WangXuan95/UniPlug-FPGA/EP4CE22/用户手册.pdf

# UniPlug-FPGAÿ%Ü£EP4CE22á§

^rÃ˛

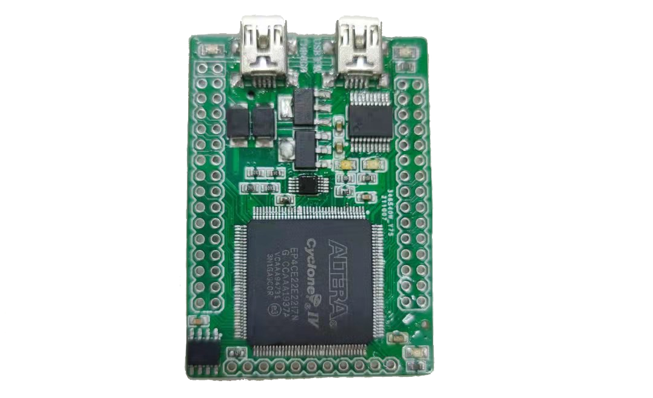
[picture p5: figure]

# https://github.com/WangXuan95

2021c9

8¹

1 {0 | 2
2 *–IO`² | 3
3 ⁄©L | 4
4 É'^áÜ°ƒ | 6
5 .qsf£Quartusë8ò©á§⁄Â | 7
6 ßSzòð | 8

1 {0

# UniPlug-FPGA¥ò±N»-

# !$§!¥^!*–5rFPGA ÿ%Ü"å±^ä.Oß½O.ÜßV \DRAM!±!USB!ADC/DAC!—™!VGA!îfi ß±§½õzıU"ßX⁄µ„Ñ„1" ßPk±eA:µ

# - FPGA .“èAltera Cyclone IV EP4CE22E22ßPk22kLE ‹6]

# ⁄594kbit Sò;"

# - 8§USB-Blaster£FPGAe1N£Ï§ßÿIá OUSB-Blaster “U¶^"

- 8§ ù)µ

# – USB-UART£CH340E§ß^u⁄˛†Åœ&"

# – 8MB SPI-flash£W25Q64§^rð"

# – Micro SD k¯"

# – CAN PHY °£TJA1050§ß^uCANoÇœ&"

# – 3 á^rLED "

# - n|*–IOµIOAßIOBß⁄IOCß43 á œIO"

# 5øµcIárIOB ⁄IOC >

# —\^aÇlÎ?ø>

# ˛ßƒKFPGA ÚÃ{§ı˛DßS" çÑe©/*–IO`²⁰

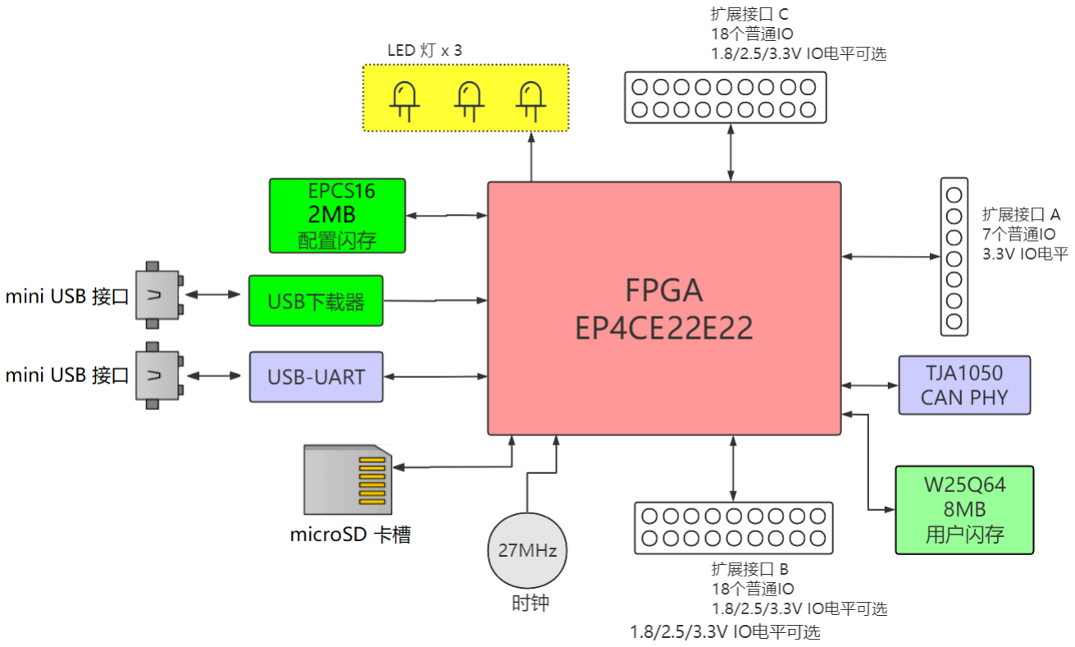
[picture p6: figure]

# „ 1: UniPlug-FPGAÿ%ÜX⁄µ„

# 2 *–IO`²

# *–IO X„2 ßù)3 áV¸2.54mmmÂ¸-

# µIOAßIOB⁄IOC"Ÿ•µ

# - IOA è½3.3V 7 á œIO"

# - IOB åòè18 á œIO ß>²å^aÇòè1.8V!2.5V ½3.3V "

# - IOC åòè18 á œIO ß>²å^aÇòè1.8V!2.5V ½3.3V "

# NIOB >²ê{¥^aÇlÚVIOB Î,òá>

>ÿ˛µ

# - IOB 3,4 “⁄^aÇl·ûßIOB >²=1.8V"

# - IOB 5,6 “⁄^aÇl·ûßIOB >²=2.5V"

# - IOB 7,8 “⁄^aÇl·ûßIOB >²=3.3V"

# ”nßNIOC >²ê{¥^aÇlÚVIOC Î,òá>

>ÿ˛µ

# - IOC 3,4 “⁄^aÇl·ûßIOC >²=1.8V"

# - IOC 5,6 “⁄^aÇl·ûßIOC >²=2.5V"

# - IOC 7,8 “⁄^aÇl·ûßIOC >²=3.3V"

# 5øµ=¶ÿ^IOB ⁄IOCßèIárVIOB ⁄VIOC ^aÇlÎ?ø>²˛ßVIOB ⁄VIOC ÿU]òßƒ KFPGA ÚÃ{§ı˛DßS" , ßX„2ßIOB1,2 “⁄˛êÑk2 á⁄ßßÇ¥å¿5V ¯>—\"å±âßÇ—\5V 5âÿ% Ü¯>"ÿ%Ük4+-

# oß ‹¯>⁄USB ¯>ÿ¿‚ßå±”û3"

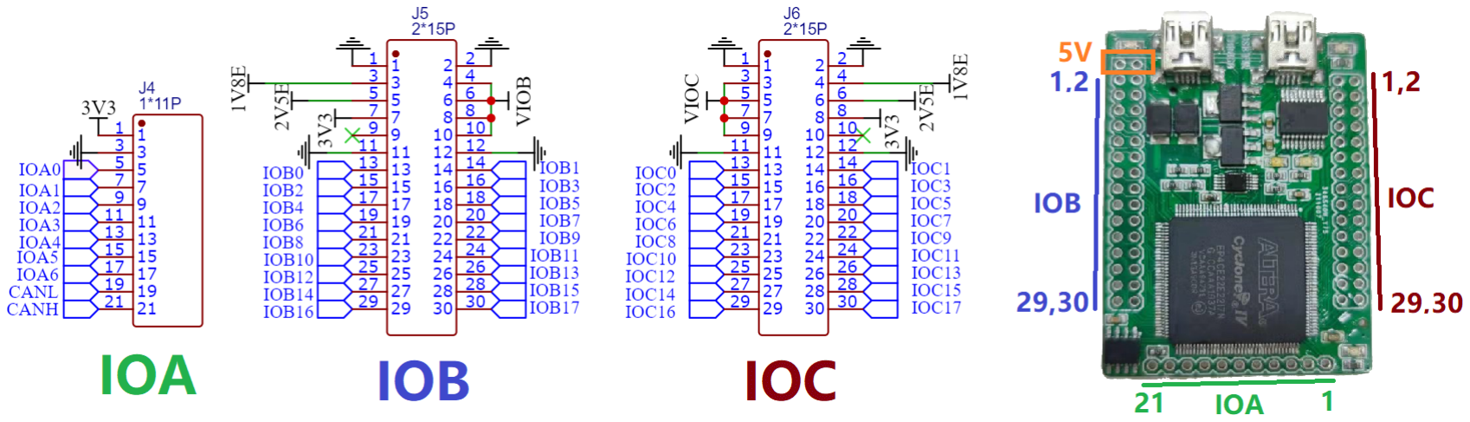
[picture p7: figure]

# „ 2: UniPlug-FPGAÿ%Ü*–IO ´ø„

3 ⁄©L

# L 1: FPGA ⁄©

| &“¶° | FPGA ⁄“ | >²

a.

# (ÈuFPGA)

# EPCS16 FPGA ò°

£òð§

| EPCS ASDO | PIN 6
| | | 3.3V

——
| EPCS NCS | PIN 8 | | ——
| EPCS DCLK | PIN 12 | | ——
| EPCS DATA0 | PIN 13 | | —\
27MHz û® | CLK27M | PIN 24 | 3.3V | —\
USB =Gù | UART RX | PIN 23 | 3.3V

—\
| UART TX | PIN 10 | | ——

W25Q64

# SPI-flash

£^rð§

| FLASH CS | PIN 87
| | | 3.3V

——
| FLASH SCK | PIN 105 | | ——
| FLASH MOSI | PIN 106 | | ——
| FLASH MISO | PIN 89 | | —\

# SDk¯

SD CLK | PIN 32

3.3V

——
SD CMD | PIN 31 | Vï
SD DAT0 | PIN 33 | Vï
SD DAT1 | PIN 80 | Vï
SD DAT2 | PIN 28 | Vï
SD DAT3 | PIN 30 | Vï

# CAN PHY

CAN RX | PIN 76
3.3V

—\
CAN TX | PIN 77 | ——

# ^rLED

LED0 | PIN 100
3.3V

——
LED1 | PIN 7 | ——
LED2 | PIN 11 | ——

# IOA

£*–ùA§

IOA0 | PIN 104

3.3V

Vï
IOA1 | PIN 103 | Vï
IOA2 | PIN 98 | Vï
IOA3 | PIN 99 | Vï
IOA4 | PIN 86 | Vï
IOA5 | PIN 83 | Vï
IOA6 | PIN 85 | Vï

# L 2: FPGA ⁄©£Y§

| &“¶° | FPGA ⁄“ | >²

a.

# (ÈuFPGA)

# IOB

£*–ùB§

IOB0 | PIN 42

# ^aÇN

# 1.8V/2.5V/3.3V

Vï
IOB1 | PIN 39 | Vï
IOB2 | PIN 44 | Vï
IOB3 | PIN 43 | Vï
IOB4 | PIN 49 | Vï
IOB5 | PIN 46 | Vï
IOB6 | PIN 51 | Vï
IOB7 | PIN 50 | Vï
IOB8 | PIN 60 | Vï
IOB9 | PIN 59 | Vï
IOB10 | PIN 65 | Vï
IOB11 | PIN 64 | Vï
IOB12 | PIN 67 | Vï
IOB13 | PIN 66 | Vï
IOB14 | PIN 69 | Vï
IOB15 | PIN 68 | Vï
IOB16 | PIN 72 | Vï
IOB17 | PIN 71 | Vï

# IOC

£*–ùC§

IOC0 | PIN 144

# ^aÇN

# 1.8V/2.5V/3.3V

Vï
IOC1 | PIN 143 | Vï
IOC2 | PIN 142 | Vï
IOC3 | PIN 141 | Vï
IOC4 | PIN 137 | Vï
IOC5 | PIN 136 | Vï
IOC6 | PIN 133 | Vï
IOC7 | PIN 132 | Vï
IOC8 | PIN 125 | Vï
IOC9 | PIN 121 | Vï
IOC10 | PIN 120 | Vï
IOC11 | PIN 119 | Vï
IOC12 | PIN 115 | Vï
IOC13 | PIN 114 | Vï
IOC14 | PIN 113 | Vï
IOC15 | PIN 112 | Vï
IOC16 | PIN 111 | Vï
IOC17 | PIN 110 | Vï

# 4 É'^áÜ°ƒ

# - Quartus IOá½°{á£Iáá“>11.0§µ

– https://www.intel.cn/content/www/cn/zh/software/programmable/quartus-prime/download.html

# – Quartus SC¨gëUSB-blaster °ƒ

# - CH340&CH341 USB-UART °ƒ£^u?1UARTœ&ßå¿§µ

# – http://www.wch.cn/downloads/CH341SER_EXE.html

# - Putty £^u?1UARTœ&ßå¿§µ

# – https://www.chiark.greenend.org.uk/~sgtatham/putty/

# 5 .qsf£Quartusë8ò©á§⁄Â

set_location_assignment PIN_24 -to CLK27M

set_location_assignment PIN_100 -to LED[0]

set_location_assignment PIN_7 -to LED[1]

set_location_assignment PIN_11 -to LED[2]

set_location_assignment PIN_10 -to UART_TX

set_location_assignment PIN_23 -to UART_RX

set_location_assignment PIN_6 -to EPCS_ASDO

set_location_assignment PIN_8 -to EPCS_NCS

set_location_assignment PIN_12 -to EPCS_DCLK

set_location_assignment PIN_13 -to EPCS_DATA0

set_location_assignment PIN_87 -to FLASH_CS

set_location_assignment PIN_105 -to FLASH_SCK

set_location_assignment PIN_106 -to FLASH_MOSI

set_location_assignment PIN_89 -to FLASH_MISO

set_location_assignment PIN_28 -to SD_DAT[2]

set_location_assignment PIN_30 -to SD_DAT[3]

set_location_assignment PIN_31 -to SD_CMD

set_location_assignment PIN_32 -to SD_CLK

set_location_assignment PIN_33 -to SD_DAT[0]

set_location_assignment PIN_80 -to SD_DAT[1]

set_location_assignment PIN_77 -to CAN_TX

set_location_assignment PIN_76 -to CAN_RX

set_location_assignment PIN_104 -to IOA[0]

set_location_assignment PIN_103 -to IOA[1]

set_location_assignment PIN_98 -to IOA[2]

set_location_assignment PIN_99 -to IOA[3]

set_location_assignment PIN_86 -to IOA[4]

set_location_assignment PIN_83 -to IOA[5]

set_location_assignment PIN_85 -to IOA[6]

set_location_assignment PIN_42 -to IOB[0]

set_location_assignment PIN_39 -to IOB[1]

set_location_assignment PIN_44 -to IOB[2]

set_location_assignment PIN_43 -to IOB[3]

set_location_assignment PIN_49 -to IOB[4]

set_location_assignment PIN_46 -to IOB[5]

set_location_assignment PIN_51 -to IOB[6]

set_location_assignment PIN_50 -to IOB[7]

set_location_assignment PIN_60 -to IOB[8]

set_location_assignment PIN_59 -to IOB[9]

set_location_assignment PIN_65 -to IOB[10]

set_location_assignment PIN_64 -to IOB[11]

set_location_assignment PIN_67 -to IOB[12]

set_location_assignment PIN_66 -to IOB[13]

set_location_assignment PIN_69 -to IOB[14]

set_location_assignment PIN_68 -to IOB[15]

set_location_assignment PIN_72 -to IOB[16]

set_location_assignment PIN_71 -to IOB[17]

set_location_assignment PIN_144 -to IOC[0]

set_location_assignment PIN_143 -to IOC[1]

set_location_assignment PIN_142 -to IOC[2]

set_location_assignment PIN_141 -to IOC[3]

set_location_assignment PIN_137 -to IOC[4]

set_location_assignment PIN_136 -to IOC[5]

set_location_assignment PIN_133 -to IOC[6]

set_location_assignment PIN_132 -to IOC[7]

set_location_assignment PIN_125 -to IOC[8]

set_location_assignment PIN_121 -to IOC[9]

set_location_assignment PIN_120 -to IOC[10]

set_location_assignment PIN_119 -to IOC[11]

set_location_assignment PIN_115 -to IOC[12]

set_location_assignment PIN_114 -to IOC[13]

set_location_assignment PIN_113 -to IOC[14]

set_location_assignment PIN_112 -to IOC[15]

set_location_assignment PIN_111 -to IOC[16]

set_location_assignment PIN_110 -to IOC[17]

# 6 ßSzòð

# ˘!·Ç0X¤rßSzEPCS16£òð°§ß˘“U[»-

# 3FPGA ßS"œèUniPlug-

# FPGA>¥ê|±JTAG ê™ßÿ|±AS ê™"§±êU^jlc©á5¹òð°" ·ÇƒkIáÚsof©á=Üèjic©áßX„3"

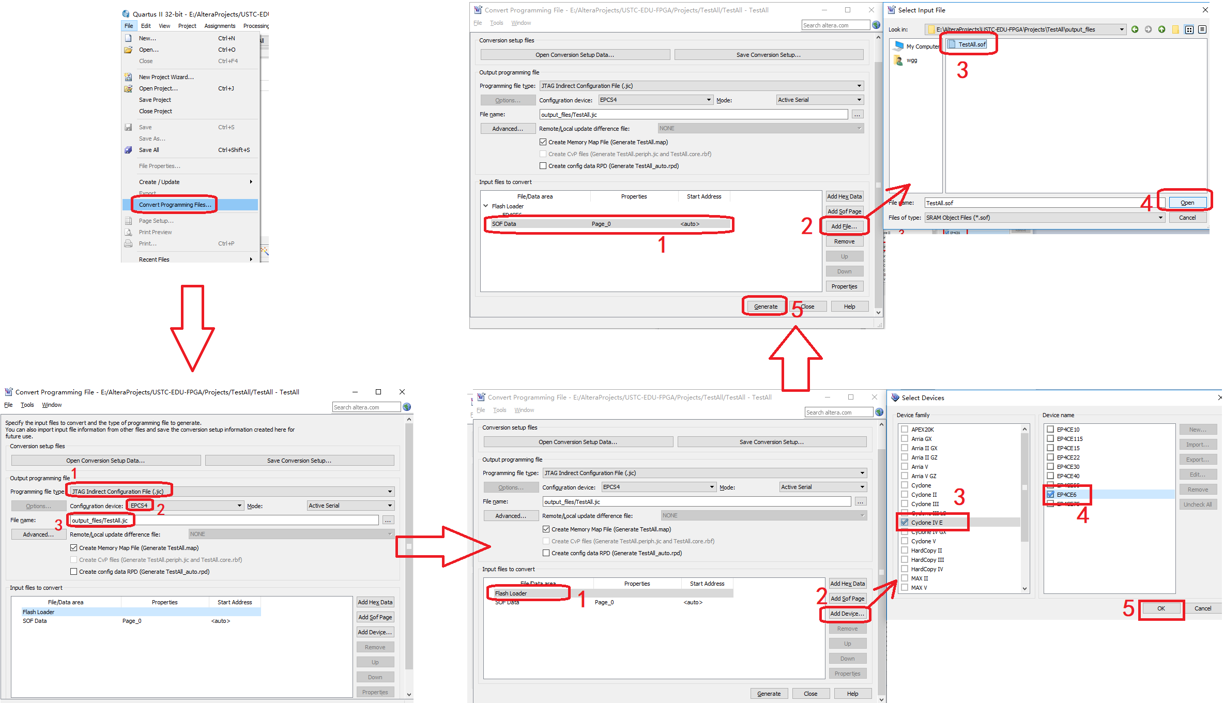
[picture p8: figure]

# „ 3: =Üsof©ájic ©á⁄½

# 1ò⁄µãmòáë8ß(-

# [ë88¹]/output files©áYeÆ²kòá?»–sof©á£evkKIá?»

# Ûß§"3Û‰9•ãmFile->Convert Programming Filesß—òáIù"

# 1⁄µç½©áa.!©á¶⁄flash°a."¿JProgramming file type è.jic¶Configuration deviceèEPCS16

# £˘¥UniPlug-FPGA˛òð.“§¶Åç½File nameè/output files/[ë8¶°].jic⁰"¢S˛jic©á¶å

# ±ëBÂß-

# )ˆÔÆßÜë8”¶ßøATò3ë88¹eoutput files©áYeßÜsof©áò3òÂ" 1n⁄µ¿JFPGA.“":¬eêFlash Loaderß2:¬m>Add Deviceß3—µpÜ˝¿JCyclone

# IV Eß23m˝¿JEP4CE22£˘¥UniPlug-FPGA˛FPGA.“§ß,:OKß§FPGA.“¿J

# 1o⁄µ¿Jñ=Üsof©á":¬eêSOF Dataß2:¬m>Add Fileß3—µp¿JÉc? »)§sof©á£òÑsofò¥ª¥[ë88¹]/output files/[ë8¶°].sof§"¿J–sof:¬OpenßÅ: ¬Generateßw§ıJ´ß:Close'4Iù",å±3[ë88¹]/output files/•Èjic©á"

k

# jic©áß·Çå±ïòð•¹ßßX„4"

# 1ò⁄µƒkÎmuÜ>Mß3Quartus^á˛ê:¬Program ß3ãm¹¿ëpß(/¿

# JUSB-Blaster"

# 1⁄µÌÿÉcsof¹¿ë£XJk{§ß:¿sof©áø:¬delete" 1n⁄µV\jic©á"ÜV\sofê{òß:¬Add File...ß¿JÉc)§.jic ©áß:¬Open" 1o⁄µ¹"3m˝¿˛Program/Configureß,:¬Startßm˛?›^m©$1"¹jicåVI á15¶ûm£'¹sof˙ı§"§¨k§ıJ´ßdû\7L-#-

# omuÜßß‚¨$1¹jicßS"

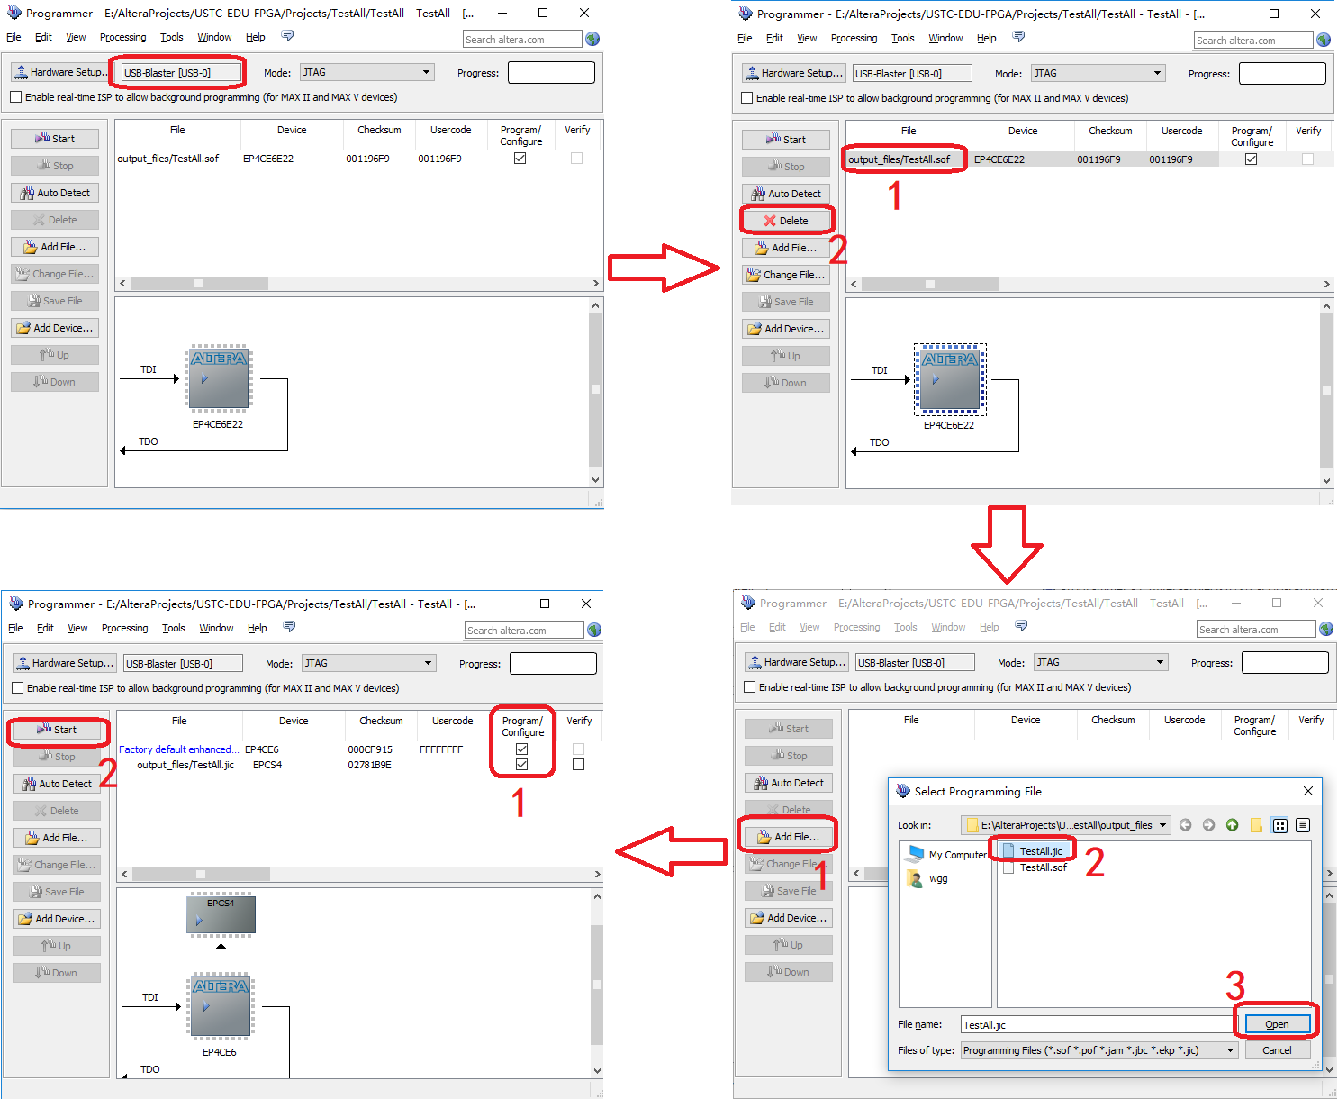
[picture p9: figure]

# „ 4: ¹jic©á⁄½
