WangXuan95/UniPlug-FPGA/用户手册/用户手册.pdf

# UniPlug-FPGAÿ%Ü

^rÃ˛

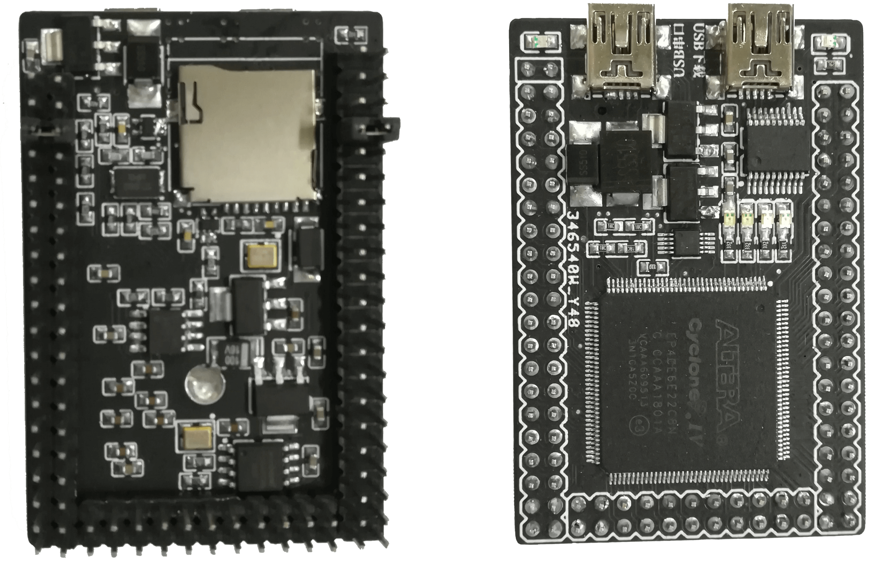
[picture p10: figure]

2021c9

8¹

1 {0 | 2
2 *–IO`² | 3
3 ⁄©L | 4
4 É'^áÜ°ƒ | 6
5 .qsf£Quartusë8ò©á§⁄Â | 7

1 {0

# UniPlug-FPGA¥ò±N»-

# !$§!¥^!*–5rFPGA ÿ%Ü"å±^ä.Oß½O.ÜßV \DRAM!±!USB!ADC/DAC!—™!VGA!îfi ß±§½õzıU"ßX⁄µ„Ñ„1⁄ „2"ßPk±eA:µ

# - FPGA .“èAltera Cyclone IV EP4CE6E22ßPk6kLE ‹6]

# ⁄270kbit Sò;"

# - 8§USB-Blaster£FPGAe1N£Ï§ßÿIá OUSB-Blaster “U¶^"

- 8§ ù)µ

# – USB-UART£CH340E§ß^u⁄˛†Åœ&"

# – 8MB SPI-flash£W25Q64§^rð"

# – Micro SD k¯"

# – 4 á^rLED "

# - n|*–IOµIOAßIOBß⁄IOCß62 á œIO"

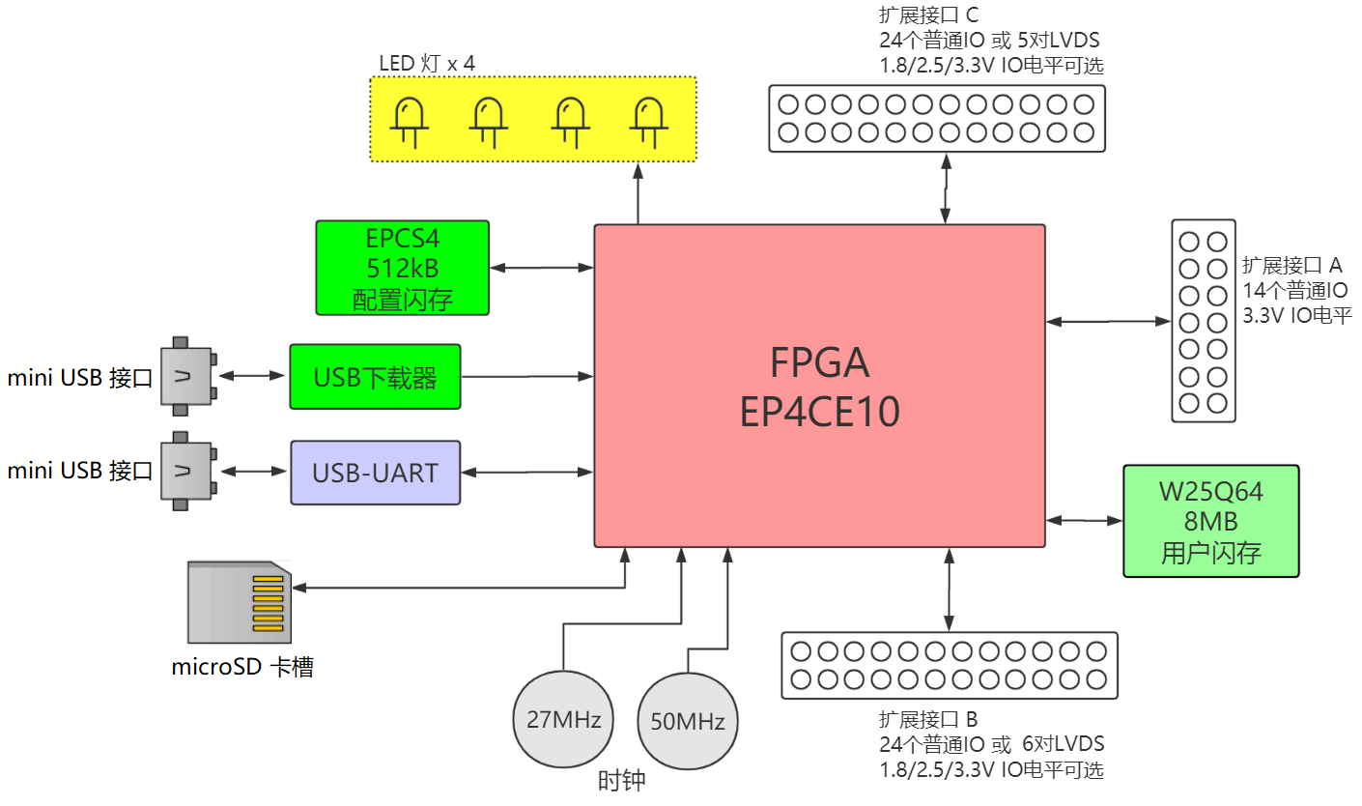
[picture p11: figure]

# „ 1: UniPlug-FPGAÿ%ÜX⁄µ„

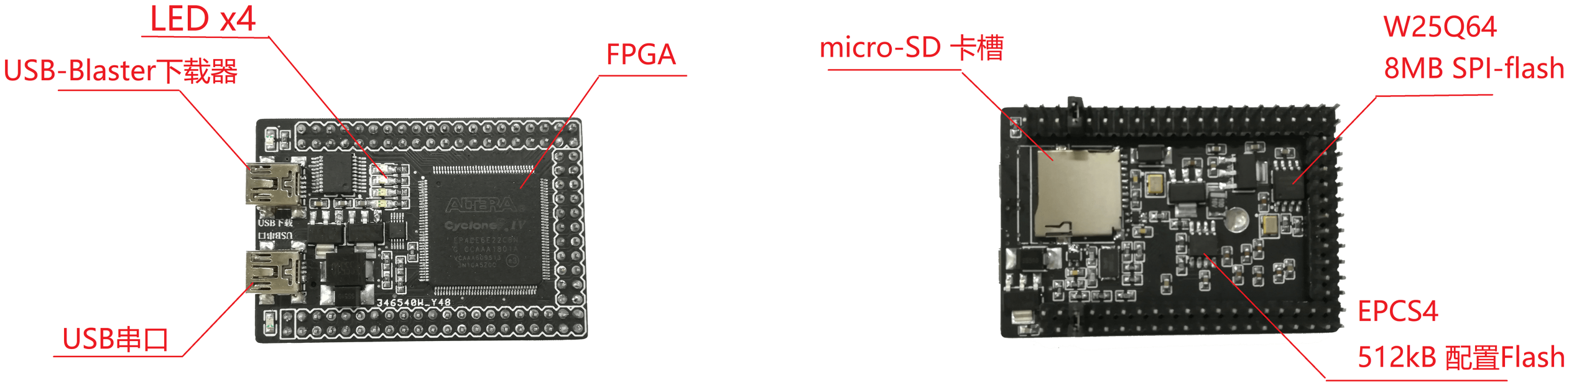
[picture p12: figure]

# „ 2: UniPlug-FPGAÿ%Ü‹á„

# 2 *–IO`²

# *–IO X„3 ßù)3 áV¸2.54mmmÂ¸-

# µIOAßIOB⁄IOC"Ÿ•µ

# - IOA è½3.3V 14 á œIO"

# - IOB åòè24 á œIO ß½6 ÈLVDSß>²å^aÇòè1.8V!2.5V ½3.3V "

# - IOC åòè24 á œIO ß½5 ÈLVDSß>²å^aÇòè1.8V!2.5V ½3.3V "

# 5µÿ%Ü˛øÿëLVDS ‡>{ße^LVDSßIá^rg13.Ü˛\‡>{" NIOB >²ê{¥^aÇlÚVIOB Î,òá>

>ÿ˛µ

# - IOB 3,4 “⁄^aÇl·ûßIOB >²=1.8V"

# - IOB 5,6 “⁄^aÇl·ûßIOB >²=2.5V"

# - IOB 7,8 “⁄^aÇl·ûßIOB >²=3.3V"

# ”nßNIOC >²ê{¥^aÇlÚVIOC Î,òá>

>ÿ˛µ

# - IOC 3,4 “⁄^aÇl·ûßIOC >²=1.8V"

# - IOC 5,6 “⁄^aÇl·ûßIOC >²=2.5V"

# - IOC 7,8 “⁄^aÇl·ûßIOC >²=3.3V"

# 5øµ=¶ÿ^IOB ⁄IOCßèIárVIOB ⁄VIOC ^aÇlÎ?ø>²˛ßVIOB ⁄VIOC ÿU]òßƒ KFPGA ÚÃ{§ı˛DßS" , ßX„3ßIOB1,2 “⁄˛êÑk2 á⁄ßßÇ¥å¿5V ¯>—\"å±âßÇ—\5V 5âÿ% Ü¯>"ÿ%Ük4+-

# oß ‹¯>⁄USB ¯>ÿ¿‚ßå±”û3"

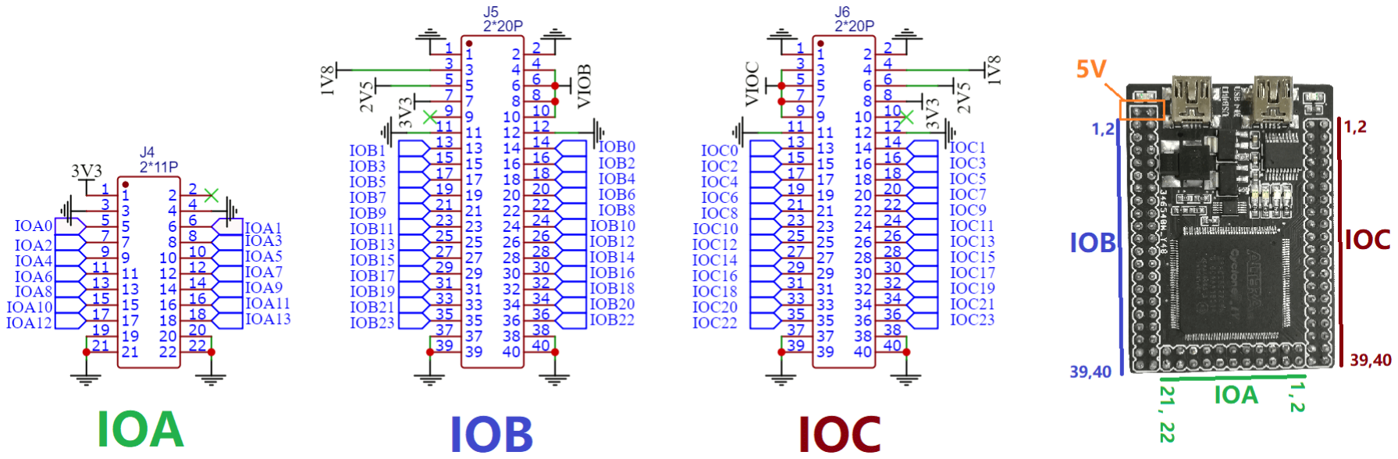
[picture p13: figure]

# „ 3: UniPlug-FPGAÿ%Ü*–IO ´ø„

3 ⁄©L

# L 1: FPGA ⁄©

| &“¶° | FPGA ⁄“ | >²

a.

# (ÈuFPGA)

# EPCS4 FPGA ò°

£òð§

| EPCS ASDO | PIN 6
| | | 3.3V

——
| EPCS NCS | PIN 8 | | ——
| EPCS DCLK | PIN 12 | | ——
| EPCS DATA0 | PIN 13 | | —\
50MHz û® | CLK50M | PIN 24 | 3.3V | —\
27MHz û® | CLK27M | PIN 90 | 3.3V | —\
USB =Gù | UART RX | PIN 23 | 3.3V

—\
| UART TX | PIN 10 | | ——

W25Q64

# SPI-flash

£^rð§

| FLASH CS | PIN 87
| | | 3.3V

——
| FLASH SCK | PIN 75 | | ——
| FLASH MOSI | PIN 74 | | ——
| FLASH MISO | PIN 84 | | —\

# SDk¯

SD CLK | PIN 32

3.3V

——
SD CMD | PIN 31 | Vï
SD DAT0 | PIN 33 | Vï
SD DAT1 | PIN 34 | Vï
SD DAT2 | PIN 28 | Vï
SD DAT3 | PIN 30 | Vï

# ^rLED

LED0 | PIN 1

3.3V

——
LED1 | PIN 2 | ——
LED2 | PIN 3 | ——
LED3 | PIN 7 | ——

# IOA

£*–ùA§

IOA0 | PIN 105

3.3V

Vï
IOA1 | PIN 106 | Vï
IOA2 | PIN 103 | Vï
IOA3 | PIN 104 | Vï
IOA4 | PIN 99 | Vï
IOA5 | PIN 100 | Vï
IOA6 | PIN 98 | Vï
IOA7 | PIN 86 | Vï
IOA8 | PIN 85 | Vï
IOA9 | PIN 83 | Vï
IOA10 | PIN 80 | Vï
IOA11 | PIN 77 | Vï
IOA12 | PIN 76 | Vï
IOA13 | PIN 73 | Vï

# L 2: FPGA ⁄©£Y§

| &“¶° | ŸßıU | FPGA ⁄“ | >²

a.

# (ÈuFPGA)

# IOB

£*–ùB§

IOB0 | LVDS-p | PIN 38

# ^aÇN

# 1.8V/2.5V/3.3V

Vï

IOB1 | LVDS-n | PIN 39 | Vï
IOB2 | | PIN 42 | Vï
IOB3 | | PIN 46 | Vï
IOB4 | | PIN 43 | Vï
IOB5 | | PIN 44 | Vï
IOB6 | LVDS-p | PIN 49 | Vï
IOB7 | LVDS-n | PIN 50 | Vï
IOB8 | | PIN 51 | Vï
IOB9 | | PIN 58 | Vï
IOB10 | LVDS-p | PIN 52 | Vï
IOB11 | LVDS-n | PIN 53 | Vï
IOB12 | LVDS-p | PIN 54 | Vï
IOB13 | LVDS-n | PIN 55 | Vï
IOB14 | LVDS-p | PIN 59 | Vï
IOB15 | LVDS-n | PIN 60 | Vï
IOB16 | | PIN 64 | Vï
IOB17 | | PIN 65 | Vï
IOB18 | | PIN 66 | Vï
IOB19 | | PIN 67 | Vï
IOB20 | | PIN 68 | Vï
IOB21 | | PIN 69 | Vï
IOB22 | LVDS-p | PIN 70 | Vï
IOB23 | LVDS-n | PIN 71 | Vï

# IOC

£*–ùC§

IOC0 | LVDS-p | PIN 144

# ^aÇN

# 1.8V/2.5V/3.3V

Vï

IOC1 | LVDS-n | PIN 143 | Vï
IOC2 | | PIN 142 | Vï
IOC3 | | PIN 141 | Vï
IOC4 | | PIN 138 | Vï
IOC5 | | PIN 137 | Vï
IOC6 | | PIN 136 | Vï
IOC7 | | PIN 135 | Vï
IOC8 | LVDS-p | PIN 133 | Vï
IOC9 | LVDS-n | PIN 132 | Vï
IOC10 | LVDS-p | PIN 129 | Vï
IOC11 | LVDS-n | PIN 128 | Vï
IOC12 | LVDS-p | PIN 127 | Vï
IOC13 | LVDS-n | PIN 126 | Vï
IOC14 | | PIN 125 | Vï
IOC15 | | PIN 124 | Vï
IOC16 | LVDS-p | PIN 121 | Vï
IOC17 | LVDS-n | PIN 120 | Vï
IOC18 | | PIN 119 | Vï
IOC19 | | PIN 115 | Vï
IOC20 | | PIN 113 | Vï
IOC21 | | PIN 112 | Vï
IOC22 | | PIN 111 | Vï
IOC23 | | PIN 110 | Vï

# 4 É'^áÜ°ƒ

# - Quartus IOá½°{á£Iáá“>11.0§µ

– https://www.intel.cn/content/www/cn/zh/software/programmable/quartus-prime/download.html

# – Quartus SC¨gëUSB-blaster °ƒ

# - CH340&CH341 USB-UART °ƒ£^u?1UARTœ&ßå¿§µ

# – http://www.wch.cn/downloads/CH341SER_EXE.html

# - Putty £^u?1UARTœ&ßå¿§µ

# – https://www.chiark.greenend.org.uk/~sgtatham/putty/

# 5 .qsf£Quartusë8ò©á§⁄Â

set_location_assignment PIN_24 -to CLK50M

set_location_assignment PIN_90 -to CLK27M

set_location_assignment PIN_1 -to LED[0]

set_location_assignment PIN_2 -to LED[1]

set_location_assignment PIN_3 -to LED[2]

set_location_assignment PIN_7 -to LED[3]

set_location_assignment PIN_10 -to UART_TX

set_location_assignment PIN_23 -to UART_RX

set_location_assignment PIN_6 -to EPCS_ASDO

set_location_assignment PIN_8 -to EPCS_NCS

set_location_assignment PIN_12 -to EPCS_DCLK

set_location_assignment PIN_13 -to EPCS_DATA0

set_location_assignment PIN_87 -to FLASH_CS

set_location_assignment PIN_75 -to FLASH_SCK

set_location_assignment PIN_74 -to FLASH_MOSI

set_location_assignment PIN_84 -to FLASH_MISO

set_location_assignment PIN_28 -to SD_DAT[2]

set_location_assignment PIN_30 -to SD_DAT[3]

set_location_assignment PIN_31 -to SD_CMD

set_location_assignment PIN_32 -to SD_CLK

set_location_assignment PIN_33 -to SD_DAT[0]

set_location_assignment PIN_34 -to SD_DAT[1]

set_location_assignment PIN_105 -to IOA[0]

set_location_assignment PIN_106 -to IOA[1]

set_location_assignment PIN_103 -to IOA[2]

set_location_assignment PIN_104 -to IOA[3]

set_location_assignment PIN_99 -to IOA[4]

set_location_assignment PIN_100 -to IOA[5]

set_location_assignment PIN_98 -to IOA[6]

set_location_assignment PIN_86 -to IOA[7]

set_location_assignment PIN_85 -to IOA[8]

set_location_assignment PIN_83 -to IOA[9]

set_location_assignment PIN_80 -to IOA[10]

set_location_assignment PIN_77 -to IOA[11]

set_location_assignment PIN_76 -to IOA[12]

set_location_assignment PIN_73 -to IOA[13]

set_location_assignment PIN_38 -to IOB[0]

set_location_assignment PIN_39 -to IOB[1]

set_location_assignment PIN_42 -to IOB[2]

set_location_assignment PIN_46 -to IOB[3]

set_location_assignment PIN_43 -to IOB[4]

set_location_assignment PIN_44 -to IOB[5]

set_location_assignment PIN_49 -to IOB[6]

set_location_assignment PIN_50 -to IOB[7]

set_location_assignment PIN_51 -to IOB[8]

set_location_assignment PIN_58 -to IOB[9]

set_location_assignment PIN_52 -to IOB[10]

set_location_assignment PIN_53 -to IOB[11]

set_location_assignment PIN_54 -to IOB[12]

set_location_assignment PIN_55 -to IOB[13]

set_location_assignment PIN_59 -to IOB[14]

set_location_assignment PIN_60 -to IOB[15]

set_location_assignment PIN_64 -to IOB[16]

set_location_assignment PIN_65 -to IOB[17]

set_location_assignment PIN_66 -to IOB[18]

set_location_assignment PIN_67 -to IOB[19]

set_location_assignment PIN_68 -to IOB[20]

set_location_assignment PIN_69 -to IOB[21]

set_location_assignment PIN_70 -to IOB[22]

set_location_assignment PIN_71 -to IOB[23]

set_location_assignment PIN_144 -to IOC[0]

set_location_assignment PIN_143 -to IOC[1]

set_location_assignment PIN_142 -to IOC[2]

set_location_assignment PIN_141 -to IOC[3]

set_location_assignment PIN_138 -to IOC[4]

set_location_assignment PIN_137 -to IOC[5]

set_location_assignment PIN_136 -to IOC[6]

set_location_assignment PIN_135 -to IOC[7]

set_location_assignment PIN_133 -to IOC[8]

set_location_assignment PIN_132 -to IOC[9]

set_location_assignment PIN_129 -to IOC[10]

set_location_assignment PIN_128 -to IOC[11]

set_location_assignment PIN_127 -to IOC[12]

set_location_assignment PIN_126 -to IOC[13]

set_location_assignment PIN_125 -to IOC[14]

set_location_assignment PIN_124 -to IOC[15]

set_location_assignment PIN_121 -to IOC[16]

set_location_assignment PIN_120 -to IOC[17]

set_location_assignment PIN_119 -to IOC[18]

set_location_assignment PIN_115 -to IOC[19]

set_location_assignment PIN_113 -to IOC[20]

set_location_assignment PIN_112 -to IOC[21]

set_location_assignment PIN_111 -to IOC[22]

set_location_assignment PIN_110 -to IOC[23]
