WangXuan95/UniPlug-FPGA/EP4CE22/examples/CanBus/CanBusConnection.png

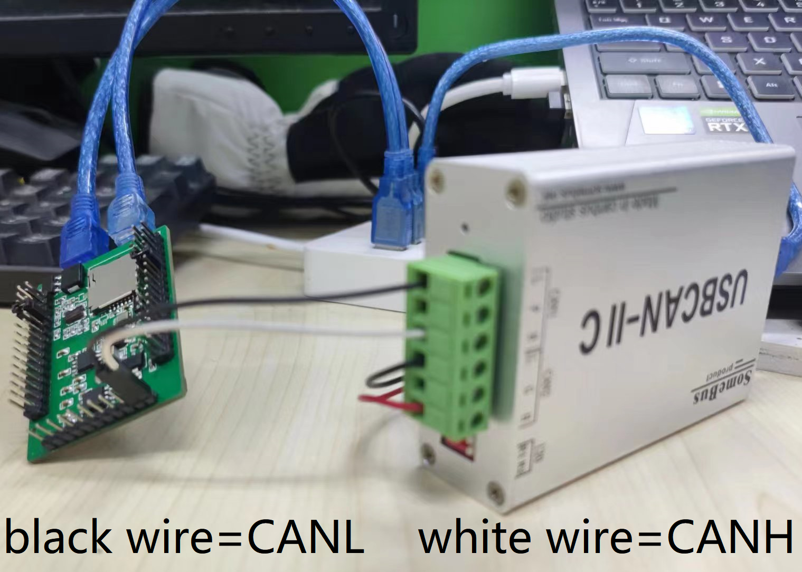
EP4CE22/examples/CanBus/CanBusConnection.png
