WangXuan95/UniPlug-FPGA/EP4CE22/制造/BOM.csv

ID | Name | Designator | Footprint | Quantity
1 | SS510 | D4,D5,D3 | SMB(DO-214AA) | 3
2 | 470R | R9,R2,R10 | R0603 | 3
3 | 0805 | LED3,LED1,LED5,LED6,LED2 | LED-0805 | 5
4 | 4k3 | R13,R20,R23,R24,R19 | R0603 | 5
5 | 100nF | C12,C28,C27,C26,C2,C5,C6,C7,C8,C15,C16,C17,C18,C19,C20,C21,C22,C23,C24,C25 | C0603 | 20
6 | XL1050 | U11 | SOIC-8_L5.0-W4.0-P1.27-LS6.0-BL | 1
7 | 2.2uF | C1,C10,C11 | C0603 | 3
8 | 1*11P | J4 | 210S-2.54-1X11P | 1
9 | 33R | R12,R11 | R0603 | 2
10 | 10k | R15,R16,R17,R18,R1,R14,R25,R26,R27 | R0603 | 9
11 | EP4CE22E22C8N | U5 | TQFP-144_L20.0-W20.0-P0.50-LS22.0-BL | 1
12 | 2*15P | J5,J6 | 210S-2.54-2X15P | 2
13 | PIC18F14K50-I/SS | U1 | SSOP-20_208MIL | 1
14 | USB_MINI | J1,J2 | USB_MINI | 2
15 | CH340E | U2 | MSOP-10 | 1
16 | AMS1117-3.3 | U6 | SOT-223 | 1
17 | AMS1117-2.5 | U9,U8 | SOT-223 | 2
18 | 2*1 | J7 | HDR-2X1/2.54 | 1
19 | 120 | R28 | R0603 | 1
20 | 27MHZ | X2 | OSC-YSX-3225_4P | 1
21 | EPCS16SI8N | U3 | SOIC-8_150MIL | 1
22 | 20pF | C3,C4 | C0603 | 2
23 | 220R | R3,R4,R5,R6,R7,R8 | R0603 | 6
24 | W25Q64FVSSIG_C138803 | U4 | SOIC-8_L5.3-W5.3-P1.27-LS8.0-BL | 1
25 | uSD SLOT | J3 | MICRO_SDCARD_SLOT | 1
26 | 5032 12MHz | X1 | NX5032 | 1
27 | ESDA6V1W5 | D1,D2 | SOT-353 | 2
28 | AMS1117-1.8 | U10 | SOT-223 | 1
29 | AMS1117-1.2 | U7 | SOT-223 | 1
30 | 47uF | C9 | CASE-B_3528 | 1
31 | SMBJ5.0CA | D6 | SMB(DO-214AA) | 1
