WangXuan95/UniPlug-FPGA/EP4CE6/制造/BOM.csv

ID | Name | Designator | Footprint | Quantity
1 | AMS1117-1.2 | U7 | SOT-223-4_L6.5-W3.5-P2.30-LS7.0-BR | 1
2 | 27MHZ | X3 | OSC-YSX-3225_4P | 1
3 | 100nF | C2,C5,C6,C7,C8,C15,C16,C17,C18,C19,C20,C21,C22,C23,C24,C25 | C0603 | 16
4 | 20pF | C3,C4 | C0603 | 2
5 | 2.2uF | C11,C12,C14,C1,C10,C13 | C0603 | 6
6 | SS510 | D3,D4,D5 | SMB(DO-214AA) | 3
7 | 10k | R1,R14,R25,R26,R27,R15,R16,R17,R18 | R0603 | 9
8 | 470R | R2,R9,R10 | R0603 | 3
9 | 220R | R3,R4,R5,R6,R7,R8 | R0603 | 6
10 | 33R | R11,R13,R12 | R0603 | 3
11 | 4k3 | R19,R20,R21,R22,R23,R24 | R0603 | 6
12 | W25Q64FVSSIG_C138803 | U4 | SOIC-8_L5.3-W5.3-P1.27-LS8.0-BL | 1
13 | uSD SLOT | J3 | MICRO_SDCARD_SLOT | 1
14 | 5032 12MHz | X1 | NX5032 | 1
15 | ESDA6V1W5 | D1,D2 | SOT-353 | 2
16 | AMS1117-1.8 | U10 | SOT-223 | 1
17 | 50MHZ | X2 | OSC-YSX-3225_4P | 1
18 | AMS1117-2.5 | U8,U9 | SOT-223 | 2
19 | 47uF | C9 | CASE-B_3528 | 1
20 | SMBJ5.0CA | D6 | SMB(DO-214AA) | 1
21 | EPCS4SI8N | U3 | SOIC-8_L4.9-W3.9-P1.27-LS6.0-TL | 1
22 | EP4CE6E22 | U5 | LQFP-144 | 1
23 | PIC18F14K50-I/SS | U1 | SSOP-20_208MIL | 1
24 | USB_MINI | J1,J2 | USB_MINI | 2
25 | CH340E | U2 | MSOP-10 | 1
26 | 0805 | LED1,LED3,LED4,LED5,LED6,LED2 | LED-0805 | 6
27 | AMS1117-3.3 | U6 | SOT-223 | 1
28 | 2*20P | J5,J6 | 210S-2.54-2X20P | 2
29 | 2*11P | J4 | 210S-2.54-2X11P | 1
30 | 2*1 | J7 | HDR-2X1/2.54 | 1
