WangXuan95/UniPlug-FPGA/EP4CE6/制造/sch.pdf

# USB-Blaster

BANK8 | BANK7

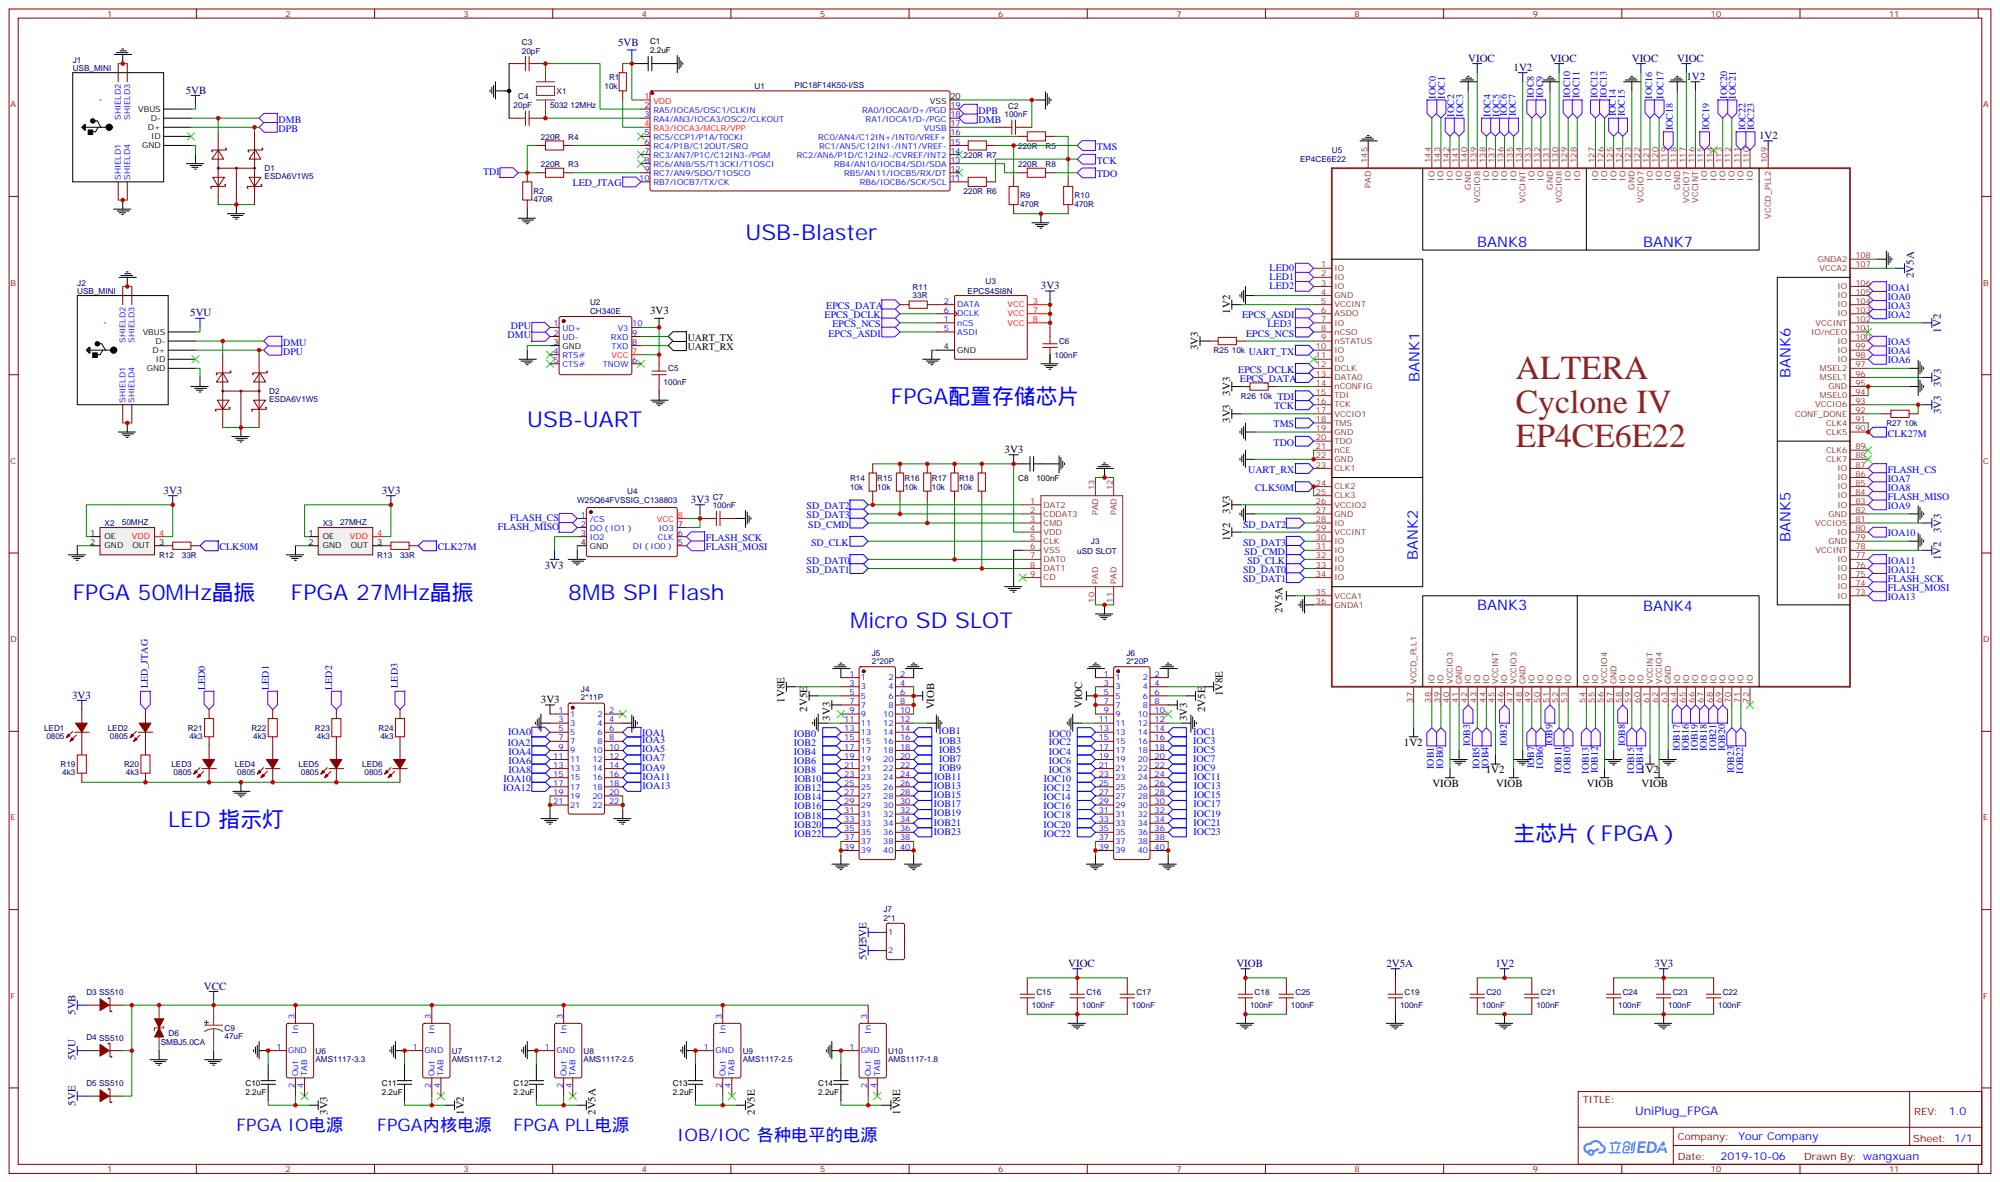
[picture p15: page 1]

IO 128 IO 129 VCCIO8 130 GND 131 IO 132 IO 133 VCCINT 134 IO 135 IO 136 IO 137 IO 138 VCCIO8 139 GND 140 IO 141 IO 142 IO 143 IO 144

IO 110 IO 111 IO 112 IO 113 IO 114 IO 115 VCCINT 116 VCCIO7 117 GND 118 IO 119 IO 120 IO 121 VCCIO7 122 GND 123 IO 124 IO 125 IO 126 IO 127
