WangXuan95/UniPlug-FPGA/EP4CE22/制造/sch.pdf

# USB-Blaster

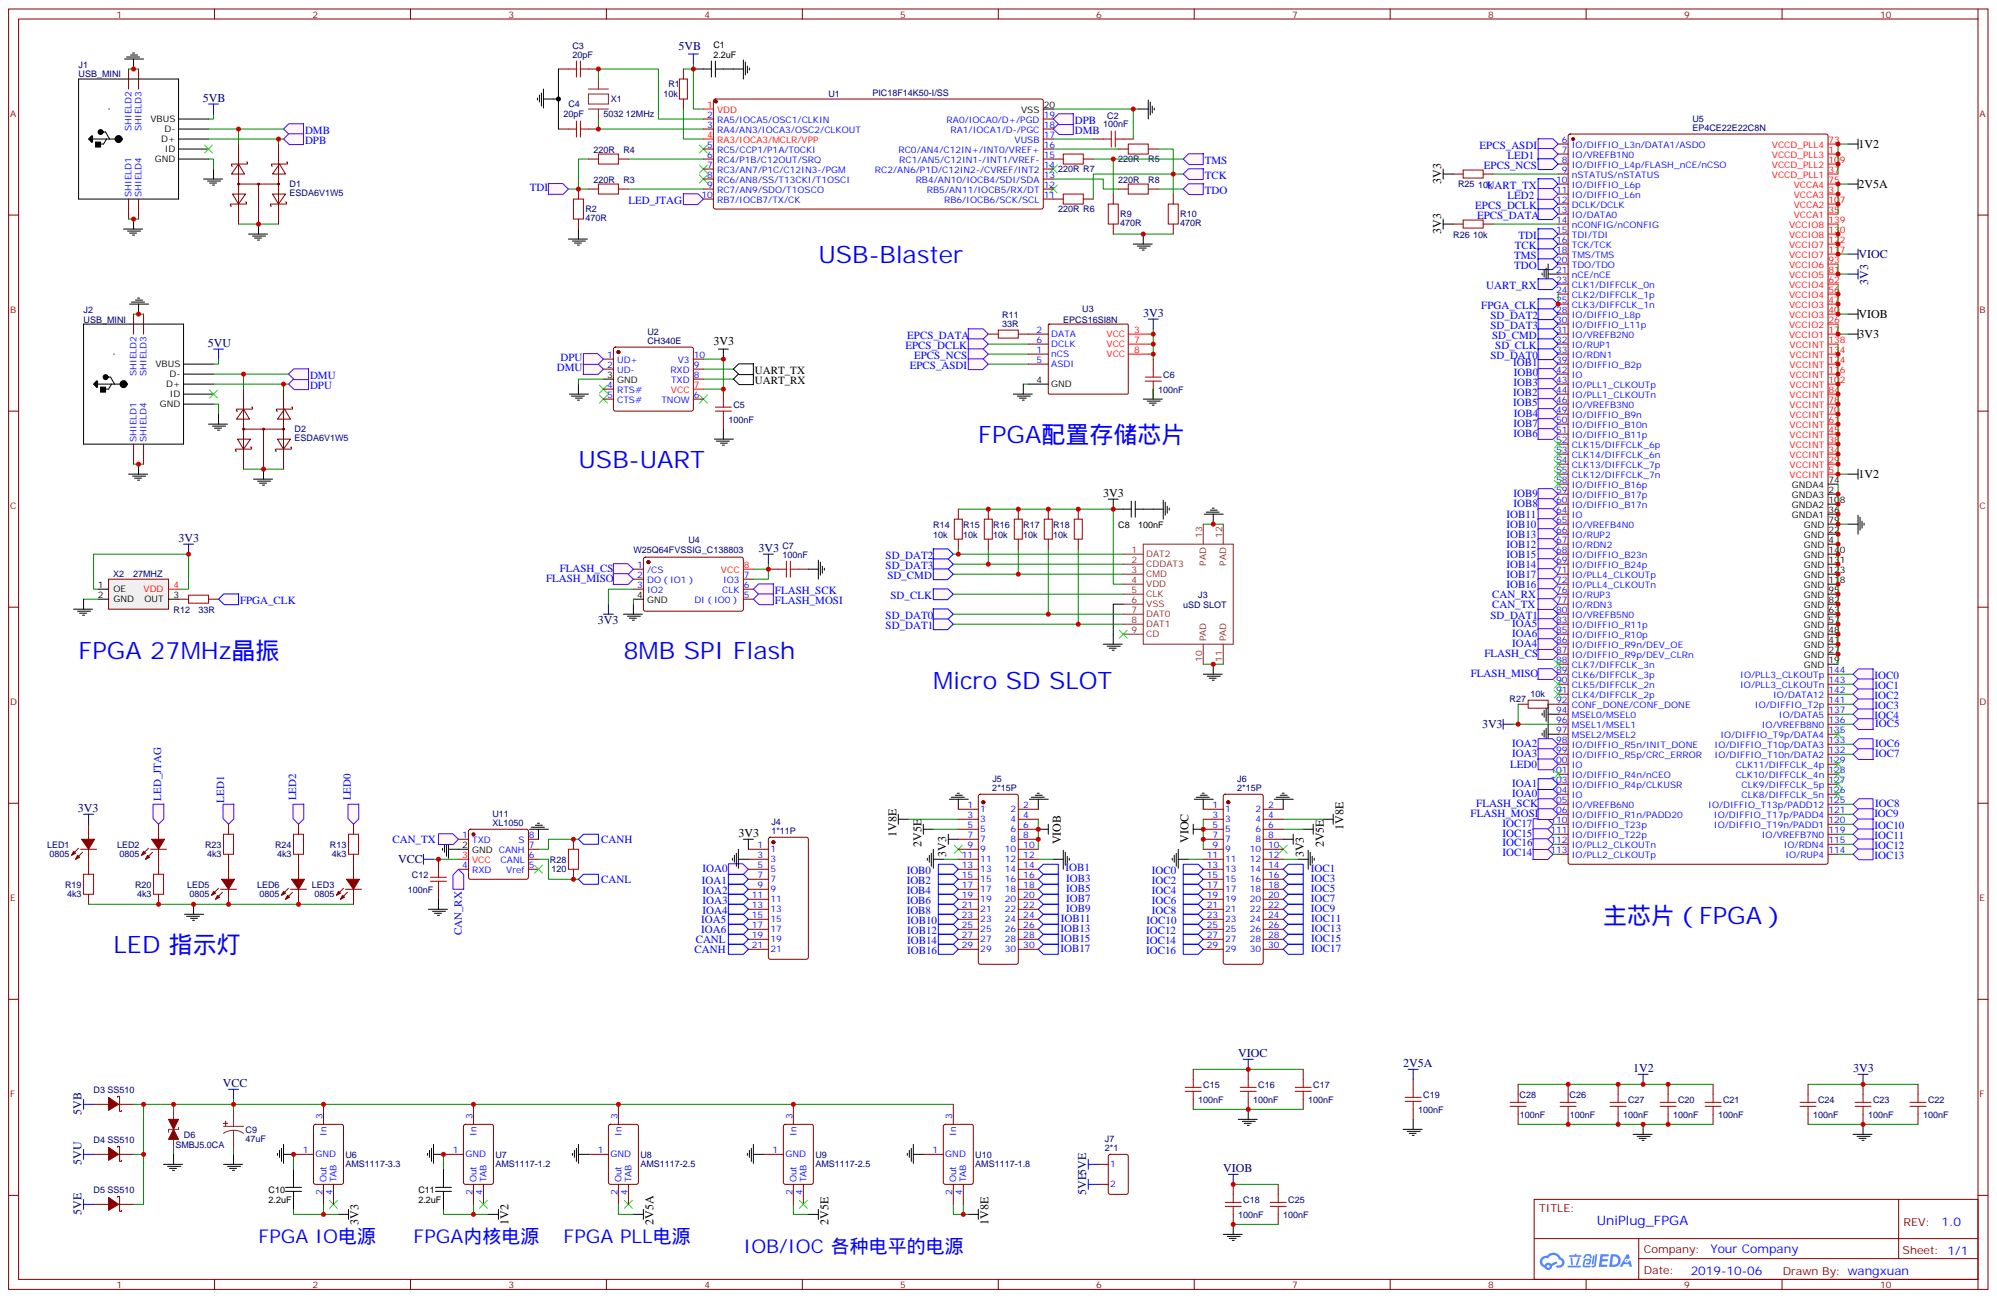
[picture p16: page 1]

2 | 69
3 | 71
4 5 | 72
