WangXuan95/UniPlug-FPGA/(commit log)

2021-10-13 细化PIC固件烧写教程，更新用户手册和示例程序
2021-10-14 硬件小改加入USB口定位孔,修改外部IO顺序
    [BOM.csv, PickAndPlace.csv]
2021-10-15 更新文档
2021-10-16 添加EP4CE22大型版本
    [BOM.csv, PickAndPlace.csv]
2021-10-16 删除多余文件
    [BOM.csv, PickAndPlace.csv]
